angelodlfrtr/attinav/hardware/kicad/components/SCHA63T-K03-05/SCHA63T-K03-05.step

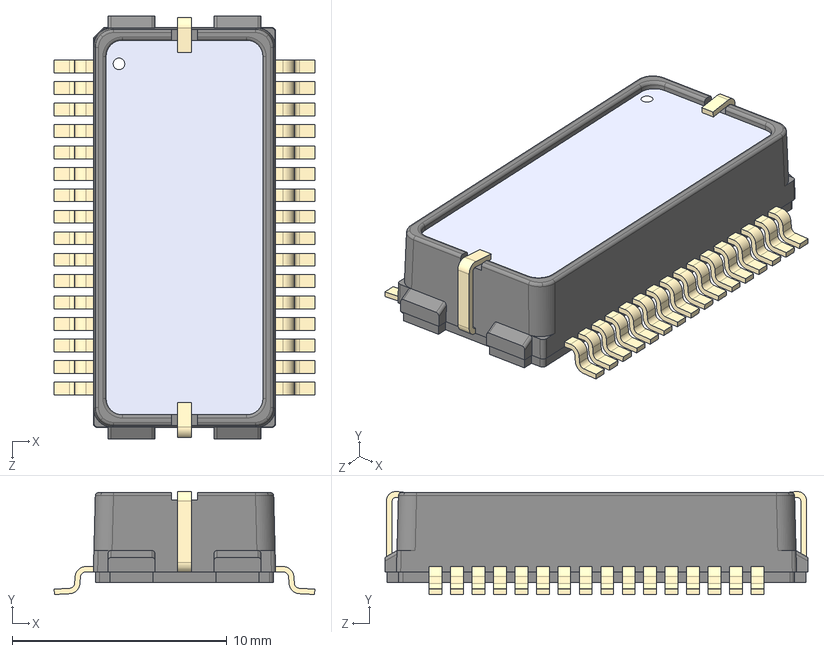
[picture p1: CAD file, 2026-02-02]
hardware/kicad/components/SCHA63T-K03-05/SCHA63T-K03-05.step
12.2 x 4.80 x 19.7 mm
