angelodlfrtr/attinav/hardware/kicad/components/STM32F401CEU6/STM32F401CEU6.stp

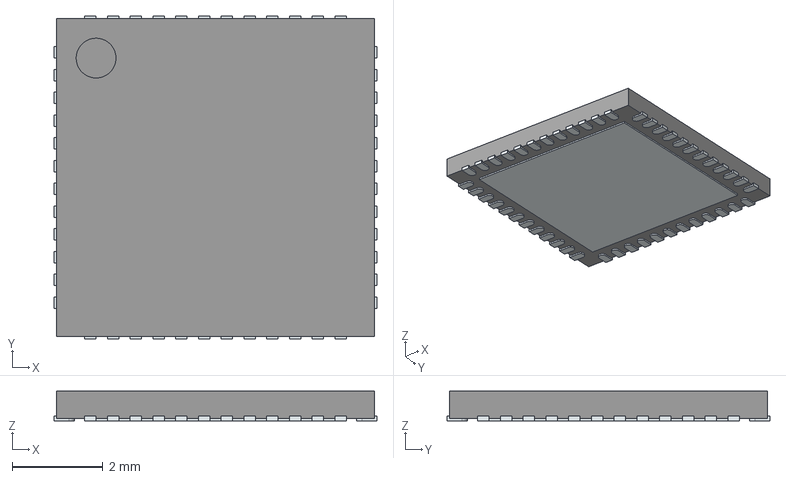
[picture p2: CAD file, 2026-02-02]
hardware/kicad/components/STM32F401CEU6/STM32F401CEU6.stp
7.10 x 7.10 x 0.65 mm
ThermalPin
PinsArrayLR
PinsArrayTB
