angelodlfrtr/attinav/hardware/kicad/components/TS-1088-AR02016/TS-1088-AR02016.step

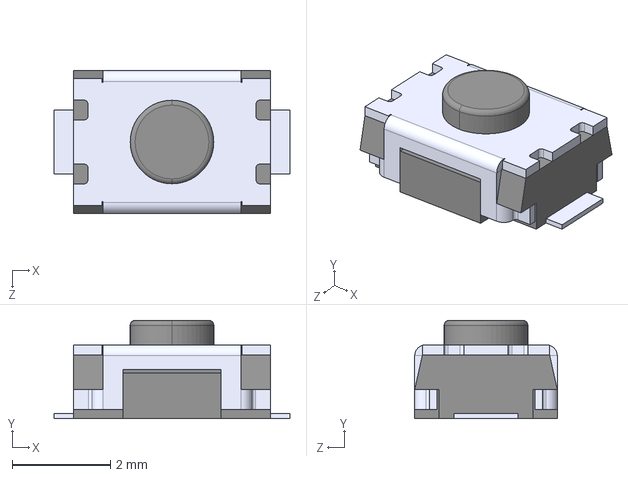
[picture p3: CAD file, 2026-02-02]
hardware/kicad/components/TS-1088-AR02016/TS-1088-AR02016.step
4.80 x 2.00 x 2.90 mm
