angelodlfrtr/attinav/hardware/kicad/components/WIT-RM3100/PNI_3100_CB.step

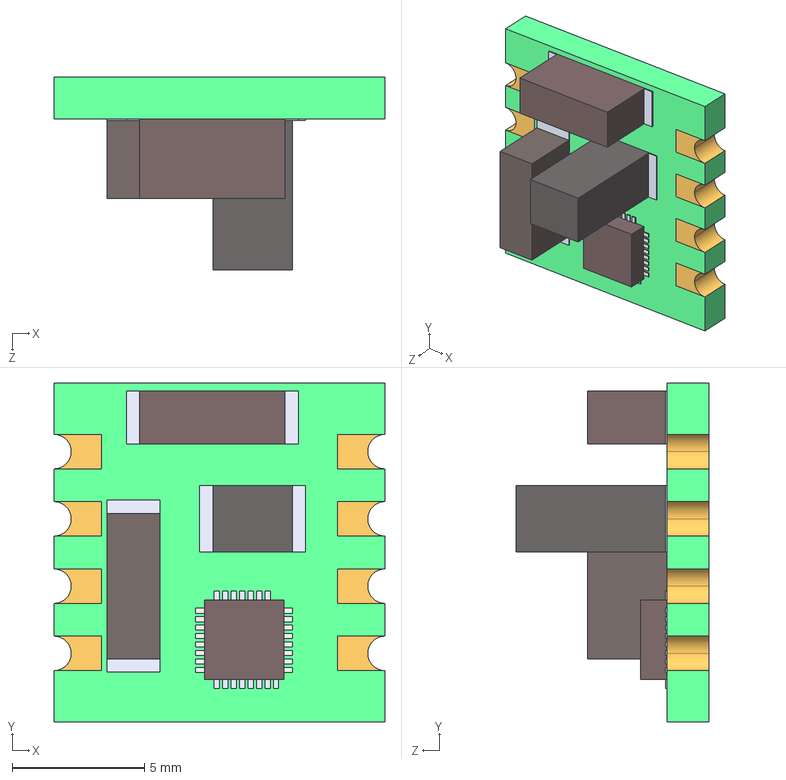
[picture p4: CAD file, 2026-02-02]
hardware/kicad/components/WIT-RM3100/PNI_3100_CB.step
12.5 x 12.8 x 7.30 mm
