angelodlfrtr/attinav/hardware/kicad/attinav.kicad_pcb

## KiCad design hardware/kicad/attinav.kicad_pcb (2026-11-10)

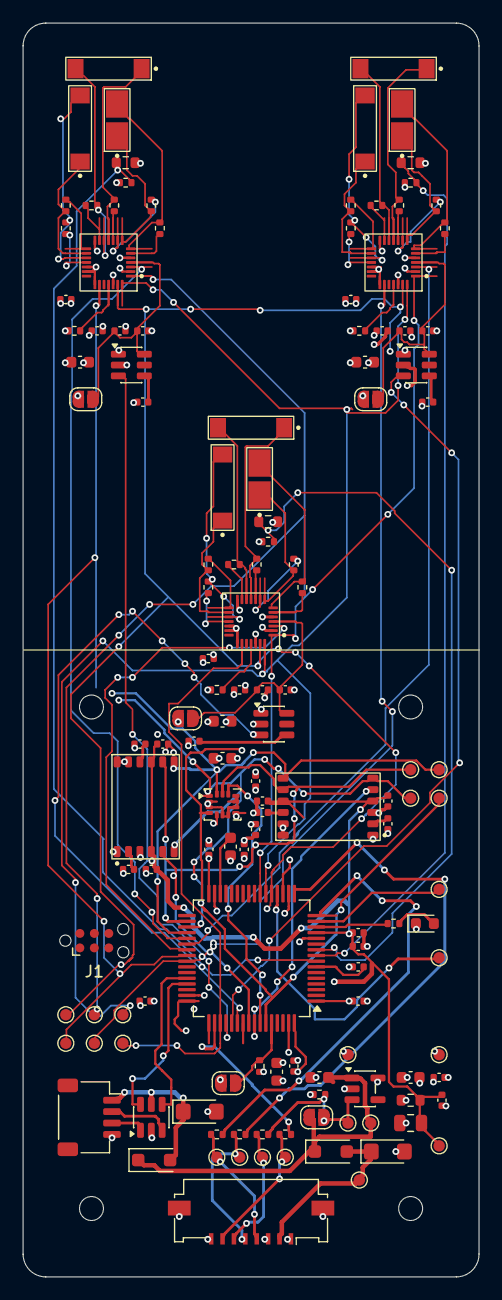
[picture p13: board attinav.kicad_pcb from above]

Board: 6 copper layers, 40.0 x 110.0 mm, 139 parts (0 on the bottom side), 96 nets.

Parts:
C1, C7, C13: 1n/X7R; C_0402_1005Metric
C2, C8, C14, C25, C41: 1u/X7R; C_0402_1005Metric
C3, C4, C5, C9, C10, C11, C15, C16, C17, C27, C34, C35, C36, C37, C39, C40, C43, C45, C46, C47, C48, C49, C50, C51, C52, C55: 100n/X7R; C_0402_1005Metric
C6, C12, C18, C24, C28: 10u/X7R; C_0603_1608Metric
C26: 22u/X7R; C_0805_2012Metric
C38, C42: 4.7u/X7R; C_0603_1608Metric
C53: 10n/X7R; C_0402_1005Metric
C54: 2.2u/X7R; C_0603_1608Metric
D2: LED GREEN; LED_0603_1608Metric
D5, D7: PMEG2010AEH; D_SOD-123F
D6, D8: SMF5V0A; D_SMF
H1, H2: DowelHole; MountingHole_2.1mm
H3, H4: MountingHole; MountingHole_2.1mm
J1: Tag-Connect_TC2030-IDC-NL_2x03_P1.27mm_Vertical
J3: USB pigtail JST SH 4p; JST_SH_SM04B-SRSS-TB_1x04-1MP_P1.00mm_Horizontal
J4: FFC 8p 1.0mm flip-lock; Molex_200528-0080_1x08-1MP_P1.00mm_Horizontal
JP1, JP2, JP3, JP5, JP6: SolderJumper_2_Open; SolderJumper-2_P1.3mm_Open_RoundedPad1.0x1.5mm
L1, L4, L7: Sen-Z-f; PNI_Sen-Z-f
L2, L3, L5, L6, L8, L9: Sen-XY-f; PNI_Sen-XY-f
R1, R9, R17: 10k/0.1%; R_0402_1005Metric
R2, R10, R18: 33k/1%; R_0402_1005Metric
R3, R4, R5, R6, R7, R8, R11, R12, R13, R14, R15, R16, R19, R20, R21, R22, R23, R24: 121R/1%; R_0402_1005Metric
R27: 100k/1%; R_0402_1005Metric
R28: 4.7R/1%; R_0603_1608Metric
R29: 10k/1%; R_0402_1005Metric
R30: 1k/1%; R_0402_1005Metric
R33, R34, R35, R36: 100R/1%; R_0402_1005Metric
TH1, TH2, TH3: PT1000; R_0603_1608Metric
TP1: TP_FFC_TX; TestPoint_Pad_D1.0mm
TP2: TP_FFC_RX; TestPoint_Pad_D1.0mm
TP3: TP_FFC_EN; TestPoint_Pad_D1.0mm
TP4: TP_FFC_QUIET; TestPoint_Pad_D1.0mm
TP6: TP_+5V; TestPoint_Pad_D1.0mm
TP7: TP_+3.3V; TestPoint_Pad_D1.0mm
TP8: TP_+3.3VA; TestPoint_Pad_D1.0mm
TP9: TP_EN; TestPoint_Pad_D1.0mm
TP10: TP_GND; TestPoint_Pad_D1.0mm
TP14: TP_SCLK; TestPoint_Pad_D1.0mm
TP15: TP_MOSI; TestPoint_Pad_D1.0mm
TP16: TP_MISO; TestPoint_Pad_D1.0mm
TP17: TP_DRDY1; TestPoint_Pad_D1.0mm
TP18: TP_DRDY2; TestPoint_Pad_D1.0mm
TP19: TP_DRDY3; TestPoint_Pad_D1.0mm
TP20: TP_PA1; TestPoint_Pad_D1.0mm
TP21: TP_PA4; TestPoint_Pad_D1.0mm
TP23: TP_ACC_SCLK; TestPoint_Pad_D1.0mm
TP24: TP_ACC_MOSI; TestPoint_Pad_D1.0mm
TP25: TP_ACC_MISO; TestPoint_Pad_D1.0mm
TP26: TP_IMU_INT; TestPoint_Pad_D1.0mm
TP27: TP_FFC_5V; TestPoint_Pad_D1.0mm
U1, U3, U5: TPS22917DBV; SOT-23-6
U2, U4, U6: MagI2C 13156; PNI_MagI2C_MLF-28_4x4mm_P0.4mm_NoEP
U7: USBLC6-2SC6; SOT-23-6
U8: TPS7A2033PDBVR; SOT-23-5
U9: STM32U575RGTx; LQFP-64_10x10mm_P0.5mm
U10: ICM-42688-P; LGA-14_3x2.5mm_P0.5mm_LayoutBorder3x4y
U13, U14: SCA3300-D01; Murata_SCA3300-D01

Connections:
+3.3VA: C26.2, C27.2, C40.1, C41.1, C45.2, C46.1, C49.2, C50.1, R28.2, TP8.1 (1_1), U9.13 (VDDA), U13.4 (VDD), U13.9 (DVIO), U14.4 (VDD), U14.9 (DVIO)
+3V3: C4.1, C5.1, C6.1, C10.1, C11.1, C12.1, C16.1, C17.1, C18.1, C24.2, C25.2, C34.1, C35.1, C36.1, C37.1, C38.1, C39.1, C53.1, C54.2, C55.2, JP1.1 (A), JP2.1 (A), JP3.1 (A), JP6.1 (A), R1.1, R9.1, R17.1, R28.1, TP7.1 (1_1), U1.1 (VIN), U2.14 (DVDD), U2.26 (DVDD), U3.1 (VIN), U4.14 (DVDD), U4.26 (DVDD), U5.1 (VIN), U6.14 (DVDD), U6.26 (DVDD), U8.5 (OUT), U9.1 (VBAT), U9.19 (VDD), U9.32 (VDD), U9.48 (VDDUSB), U9.64 (VDD), U10.5 (VDDIO), U10.8 (VDD)
+5V: C28.2, D5.1 (K), D7.1 (K), JP5.1 (A), TP6.1 (1_1), U8.1 (IN)
/5V_FFC: D5.2 (A), D6.1 (A1), J4.2, TP27.1 (1_1)
/ACC_MISO: TP25.1 (1_1), U9.35 (PB14), U10.1 (AP_SDO/AP_AD0), U13.6 (MISO), U14.6 (MISO)
/ACC_MOSI: TP24.1 (1_1), U9.36 (PB15), U10.14 (AP_SDA/AP_SDIO/AP_SDI), U13.7 (MOSI), U14.7 (MOSI)
/ACC_SCLK: TP23.1 (1_1), U9.34 (PB13), U10.13 (AP_SCL/AP_SCLK), U13.8 (SCK), U14.8 (SCK)
/AVDD_EN1: U1.3 (ON), U9.52 (PC11)
/AVDD_EN2: U3.3 (ON), U9.53 (PC12)
/AVDD_EN3: U5.3 (ON), U9.54 (PD2)
/CS_ACC1: U9.56 (PB4), U13.5 (CSB)
/CS_ACC2: U9.57 (PB5), U14.5 (CSB)
/CS_IMU: U9.58 (PB6), U10.12 (AP_CS)
/CS_MAG1: U2.3 (SSN/SA0), U9.37 (PC6)
/CS_MAG2: U4.3 (SSN/SA0), U9.38 (PC7)
/CS_MAG3: U6.3 (SSN/SA0), U9.39 (PC8)
/DRDY_MAG1: TP17.1 (1_1), U2.23 (DRDY), U9.40 (PC9)
/DRDY_MAG2: TP18.1 (1_1), U4.23 (DRDY), U9.41 (PA8)
/DRDY_MAG3: TP19.1 (1_1), U6.23 (DRDY), U9.51 (PC10)
/EN: JP5.2 (B), R27.2, R33.2, TP9.1 (1_1), U8.3 (EN)
/IMU_INT: TP26.1 (1_1), U9.59 (PB7), U10.4 (INT1/INT)
/INTERFACE/FFC_EN: J4.6, R33.1, TP3.1 (1_1)
/INTERFACE/FFC_QUIET: J4.7, R34.1, TP4.1 (1_1)
/INTERFACE/FFC_RX: J4.5, R35.1, TP2.1 (1_1)
/INTERFACE/FFC_TX: J4.4, R36.1, TP1.1 (1_1)
/MAG1/AVDD_SW: C2.1, C3.1, JP1.2 (B), U1.6 (VOUT), U2.4 (AVDD)
/MAG2/AVDD_SW: C8.1, C9.1, JP2.2 (B), U3.6 (VOUT), U4.4 (AVDD)
/MAG3/AVDD_SW: C14.1, C15.1, JP3.2 (B), U5.6 (VOUT), U6.4 (AVDD)
/MCU/BOOT0: JP6.2 (B), R29.2, U9.60 (PH3)
/MCU/NRST: C43.2, U9.7 (NRST)
/MCU/TP_PA1: TP20.1 (1_1), U9.15 (PA1)
/MCU/TP_PA4: TP21.1 (1_1), U9.20 (PA4)
/MCU/USB_DM: U7.4 (I/O2), U9.44 (PA11)
/MCU/USB_DP: U7.6 (I/O1), U9.45 (PA12)
/QUIET: R34.2, U9.50 (PA15)
/SPI_MISO: TP16.1 (1_1), U2.28 (MISO/SA1), U4.28 (MISO/SA1), U6.28 (MISO/SA1), U9.22 (PA6)
/SPI_MOSI: TP15.1 (1_1), U2.1 (MOSI/SDA), U4.1 (MOSI/SDA), U6.1 (MOSI/SDA), U9.23 (PA7)
/SPI_SCLK: TP14.1 (1_1), U2.27 (SCLK/SCL), U4.27 (SCLK/SCL), U6.27 (SCLK/SCL), U9.21 (PA5)
/TEMP_MAG1: R1.2, TH1.1, U9.8 (PC0)
/TEMP_MAG2: R9.2, TH2.1, U9.9 (PC1)
/TEMP_MAG3: R17.2, TH3.1, U9.10 (PC2)
/UART_RX: R35.2, U9.17 (PA3)
/UART_TX: R36.2, U9.16 (PA2)
/VBUS: D7.2 (A), D8.1 (A1), J3.1, U7.5 (VBUS)
GND: C1.1, C2.2, C3.2, C4.2, C5.2, C6.2, C7.1, C8.2, C9.2, C10.2, C11.2, C12.2, C13.1, C14.2, C15.2, C16.2, C17.2, C18.2, C24.1, C25.1, C26.1, C27.1, C28.1, C34.2, C35.2, C36.2, C37.2, C38.2, C39.2, C40.2, C41.2, C42.1, C43.1, C45.1, C46.2, C47.1, C48.1, C49.1, C50.2, C51.1, C52.1, C53.2, C54.1, C55.1, D2.1 (K), D6.2 (A2), D8.2 (A2), J3.4, J4.1, J4.3, J4.8, J4.MP (MountPin), R2.1, R10.1, R18.1, R27.1, R29.1, TH1.2, TH2.2, TH3.2, TP10.1 (1_1), U1.2 (GND), U2.2 (RES), U2.5 (AVSS), U2.19 (DVSS), U2.20 (RES), U2.22 (I2CEN), U3.2 (GND), U4.2 (RES), U4.5 (AVSS), U4.19 (DVSS), U4.20 (RES), U4.22 (I2CEN), U5.2 (GND), U6.2 (RES), U6.5 (AVSS), U6.19 (DVSS), U6.20 (RES), U6.22 (I2CEN), U7.2 (GND), U8.2 (GND), U9.12 (VSSA), U9.18 (VSS), U9.31 (VSS), U9.47 (VSS), U9.63 (VSS), U10.2 (RESV), U10.3 (RESV), U10.6 (GND), U10.7 (RESV), U10.9 (INT2/FSYNC/CLKIN), U10.10 (RESV), U10.11 (RESV), U13.1 (AVSS), U13.3 (RESERVED), U13.11 (DVSS), U13.12 (EMC_GND), U14.1 (AVSS), U14.3 (RESERVED), U14.11 (DVSS), U14.12 (EMC_GND)
unnamed: D2.2 (A), R30.2
unnamed: J3.2, U7.3 (I/O2)
unnamed: J3.3, U7.1 (I/O1)
unnamed: L1.1 (1_POL), R4.1, U2.8 (ZINN)
unnamed: L4.1 (1_POL), R12.1, U4.8 (ZINN)
unnamed: L7.1 (1_POL), R20.1, U6.8 (ZINN)
unnamed: C1.2, U1.4 (CT)
unnamed: R2.2, U2.25 (REXT)
unnamed: R5.2, U2.18 (XDRVN)
unnamed: R8.2, U2.15 (XDRVP)
unnamed: L3.2, R5.1, U2.17 (XINN)
unnamed: L3.1, R8.1, U2.16 (XINP)
unnamed: R3.2, U2.13 (YDRVN)
unnamed: R6.2, U2.10 (YDRVP)
unnamed: L2.2, R3.1, U2.12 (YINN)
unnamed: L2.1, R6.1, U2.11 (YINP)
unnamed: R4.2, U2.9 (ZDRVN)
unnamed: R7.2, U2.6 (ZDRVP)
unnamed: L1.2, R7.1, U2.7 (ZINP)
unnamed: C7.2, U3.4 (CT)
unnamed: R10.2, U4.25 (REXT)
unnamed: R13.2, U4.18 (XDRVN)
unnamed: R16.2, U4.15 (XDRVP)
unnamed: L6.2, R13.1, U4.17 (XINN)
unnamed: L6.1, R16.1, U4.16 (XINP)
unnamed: R11.2, U4.13 (YDRVN)
unnamed: R14.2, U4.10 (YDRVP)
unnamed: L5.2, R11.1, U4.12 (YINN)
unnamed: L5.1, R14.1, U4.11 (YINP)
unnamed: R12.2, U4.9 (ZDRVN)
unnamed: R15.2, U4.6 (ZDRVP)
unnamed: L4.2, R15.1, U4.7 (ZINP)
unnamed: C13.2, U5.4 (CT)
unnamed: R18.2, U6.25 (REXT)
unnamed: R21.2, U6.18 (XDRVN)
unnamed: R24.2, U6.15 (XDRVP)
unnamed: L9.2, R21.1, U6.17 (XINN)
unnamed: L9.1, R24.1, U6.16 (XINP)
unnamed: R19.2, U6.13 (YDRVN)
unnamed: R22.2, U6.10 (YDRVP)
unnamed: L8.2, R19.1, U6.12 (YINN)
unnamed: L8.1, R22.1, U6.11 (YINP)
unnamed: R20.2, U6.9 (ZDRVN)
unnamed: R23.2, U6.6 (ZDRVP)
unnamed: L7.2, R23.1, U6.7 (ZINP)
unnamed: R30.1, U9.14 (PA0)
unnamed: C42.2, U9.30 (VCAP)
unnamed: C48.2, U13.2 (A_EXTC)
unnamed: C47.2, U13.10 (D_EXTC)
unnamed: C52.2, U14.2 (A_EXTC)
unnamed: C51.2, U14.10 (D_EXTC)
