angelodlfrtr/attinav/(commit log)

2026-09-20 Before rework
    [attinav.kicad_pcb, attinav.kicad_sch]
2026-11-01 docs(hardware): add Rev A review and Rev B design notes
    Rev A review found three functional defects, verified against a
    kicad-cli netlist and direct PCB geometry parsing rather than the
    Konnect audit tools, which report false positives on this project:
    - D1/D2 Schottky pair has a floating common node and protects nothing
    - NT1 net-tie hard-shorts BOOT0 to GND, defeating the J1 boot jumper
    - C15/C16 are 20pF against Y1's CL=20pF; need 33pF (~+60ppm fast)
    README.md records the full review plus the Rev B architecture and the
    reasoning behind it: the tan(magnetic dip) ~2x amplification of tilt
    error into azimuth error, the error budget reaching 0.1 deg azimuth /
    0.05 deg inclination, sensor se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
2026-11-01 docs(hardware): size rationale, datum correction, housing interface spec
    Scope the housing material explicitly as an interface spec the module
    depends on, not a design — this repo covers the AHRS module only.
    Board grows 80x36 -> 110x40 mm. Record why that is comfortable rather
    than minimal: four of the five error-budget terms are size-independent,
    so the accuracy-limited minimum is ~70x35 mm and nothing in the budget
    improves above ~75x35. Board length is bought for anomaly-detection
    sensitivity instead — a 35 nT anomaly is the whole 0.1 deg azimuth
    budget, and detecting it has only 2x margin at a 20 mm baseline versus
    5x at 50 mm. Note the transverse baseline is capped at ~25 mm by th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
2026-11-01 docs(hardware): fix H1 verification path, Rev A was never fabricated
    The H1 eddy-current task said to test against the Rev A board, but Rev A
    was only designed, never built, so there is no hardware to measure.
    Replace with three viable paths: check the PNI sensor suite manual
    (free, may settle it); design around it with the hybrid non-conductive
    nose (cheap, needs no answer); or buy one assembled RM3100 breakout
    (~EUR 35) alongside the Phase 2 parts order to get the actual number,
    which also gives an early target for calibration firmware.
    Note explicitly that deferring H1 to Rev B bring-up while committing to
    a one-piece aluminium chassis is the one combination to avoid, since a
    single bil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
2026-11-01 docs(hardware): scope the smartphone to bench tool and reference source
    Split the previously blanket "iPhone / 3D scan: out of scope" decision.
    3D scan integration stays parked as a carrier-level feature needing no
    module changes. The phone itself earns a narrow, zero-development role:
    - Magnetic screening during part selection, which is immediately useful
    given no hardware exists yet. Records the honest limit: ~0.1-0.5 uT
    resolution against a 35 nT budget answers "is this steel?" and nothing
    finer, so it covers dowels, cells and tripod inserts but not a single
    0603's Ni barrier termination.
    - Position -> IGRF/WMM for expected |B|, dip and declination, plus time
    and position for s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
2026-11-01 docs(hardware): resolve H1 and fix coil decoupling guidance from PNI manual
    Checked the RM3100 & RM2100 Sensor Suite User Manual, Doc 1017252 R07.
    H1 (eddy-current loading of the coils by a nearby aluminium housing)
    is downgraded from blocking to low risk. Section 4.2.2 lists only three
    hazards -- large electric currents, large masses of FERROUS material,
    and permanent magnets -- and a keyword search of the manual for eddy /
    aluminium / conductive / metal / enclosure / housing returns nothing.
    Weak but real evidence against the concern, since the RM3100 ships in
    drone, marine and space products that sit inside aluminium structures.
    The hybrid non-conductive nose stays preferred as cheap ins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
2026-11-01 docs(hardware): fix six issues found in a full logic recheck
    A. Housing argument was internally inconsistent. The theta ~= 2*delta/L
    analysis that "caps a printed housing at 0.25 deg" only applies to a
    removable board relocated by dowels, but H12 already requires the
    board to be bonded and the sensor->sight-axis transform calibrated.
    Under those conditions dowel clearance is irrelevant and only later
    movement matters. Rewrite the section as "The housing requirement,
    corrected": the hard requirement is dimensional stability (CTE,
    creep, moisture), not locating precision. Machined aluminium stays
    the recommendation on stability and thermal-mass grounds; soften H2
    fro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
2026-11-01 chore(hardware): untrack .history/ nested-repo gitlink
    hardware/kicad/.history is an editor local-history folder that
    initialises its own .git. "Before rework" (268ad54) swept it into the
    index as a bare gitlink (mode 160000, no .gitmodules), so it showed as a
    phantom modified submodule on every status and the .gitignore rule added
    in e24f976 could not take effect -- ignore rules never apply to tracked
    paths.
    Removed from the index only (--cached); the directory and its contents
    are untouched on disk. With the entry gone, .gitignore:51 now matches it.
    Assisted-by: Claude Code (Claude Fable 5.1, claude-fable-5-1)
2026-11-01 docs(hardware): correct board geometry claims from a placement calculation
    Re-derived the 110x40 mm floorplan from real footprint dimensions rather
    than re-reading earlier prose. The board size stands; three statements
    about it did not.
    Triad envelope. Each magnetometer triad is an 8x20 mm block -- coils
    (8x8) + the >=5 mm gap PNI requires between coils and capacitors + the
    MagI2C with its decoupling (7x7) -- not the ~15 mm square assumed
    earlier. Recomputed baselines: A-B 28 mm (was stated as 24), A-C/B-C
    35.8 mm (was stated as ~40). Gradient floor 59 nT/m, 3.6x margin on the
    210 nT/m threat. Dowel span L=44 mm, theta 0.016 deg.
    Missing load-bearing rule. Every triad must be oriented with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
2026-11-01 docs(hardware): final parts-list review -- six changes, core sensors confirmed
    Challenged every part against real alternatives. RM3100 x3, SCA3300-D01
    x2, ICM-42688-P and the TPS7A20-class LDO all hold: SCL3300's high-res
    modes are +/-10 deg (useless at +/-90), IIS2ICLX is 2-axis, ADXL355 has
    thermal-gradient sensitivity, servo accelerometers are the only genuine
    step up and are single-axis at ~10x cost. The parts are not the accuracy
    limiter.
    Six changes to the supporting BOM:
    1. Drop both per-accelerometer TMP117s. The SCA3300 exposes a die
    temperature sensor (Table 3: 18.9 LSB/degC, 0.053 degC resolution,
    +/-10 degC absolute offset) read in the same SPI frame. Compensation
    uses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
2026-11-01 docs(hardware): JLCPCB as the fab -- constraints become design inputs
    The board will be hand-drawn and fabricated and assembled at JLCPCB.
    Their published 6-layer capabilities, verified Nov 2026, force or
    resolve several open decisions:
    Surface finish: JLCPCB offers only OSP or ENIG at 6 layers -- no HASL
    (planarity), no immersion silver. The "never ENIG" rule therefore
    collapses to OSP, which is also the best outcome: non-metallic, the
    flattest finish for the 0.4 mm MLF, no surcharge. Caveat recorded: ~6
    month shelf life and bare copper on rework, so order fab and assembly
    together.
    Stackup: JLC06161H-3313 confirmed as Rev A's intent. In2/In3 sit across
    the 0.109 mm 2116 prepreg, so the t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
2026-11-01 docs(hardware): KiCad Board Setup values ready for transcription
    The intent was to enter the JLCPCB stackup and design rules into the
    KiCad project via Konnect. That is blocked this session: the Konnect MCP
    server is disconnected, and both targets (.kicad_pro constraints,
    .kicad_pcb stackup and copper_finish) are protected files that must not
    be edited directly. Instead, record the exact Board Setup field values
    so the entry is a transcription job, via a fresh Konnect session or the
    GUI.
    Constraints: min clearance 0.15, min track 0.15, min via 0.45/0.3,
    annular 0.075, through-hole 0.3, copper-to-hole 0.25, copper-to-edge
    0.25, hole-to-hole 0.25 with a note that JLCPCB's PTH-to-PTH limit of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
2026-11-01 docs(hardware): interconnect -- UART over 8-pin latching FFC, with reasoning
    The roadmap already named "UART over 8-pin FFC" but gave only the
    loop-area argument. Record the decisive one: housing path 2 bonds the
    AHRS board to the chassis and captures its position by calibration, so
    the carrier link must be mechanically compliant. Any rigid bridge --
    castellated edges, stacking headers, mezzanine connectors -- transmits
    carrier flex, screen presses and assembly tolerance into the calibrated
    frame. Castellations additionally make the carrier the structural
    reference and put its copper under the coil zone.
    Specify 1.0 mm pitch flip-latch FFC connectors on both boards, and spend
    the two spare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
2026-11-01 hardware: clear Rev A design to start Rev B in place
    Rev A schematic and board removed from the working project to begin the
    Rev B redraw in the same KiCad project, so the 6-layer stackup and board
    setup carry over. Rev A remains complete at 268ad54 ("Before rework");
    the Rev A defect review in hardware/kicad/README.md refers to that
    revision.
    What survived the clear-out: the .kicad_pcb setup and stackup block
    (still copper_finish "None" and Rev A thicknesses -- to be updated per
    ROADMAP "KiCad Board Setup -- values to enter") and the Default/Power
    netclass definitions. Netclass assignments are null and must be re-made
    as Rev B nets appear.
    Assisted-by: Claude Code (Claude Fable 5.1, claud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
    [attinav.kicad_pcb, attinav.kicad_sch]
2026-11-01 hardware: board setup -- JLC06161H-3313 stackup, OSP, JLCPCB constraints
    Entered in KiCad Board Setup and verified on disk against the targets in
    ROADMAP "KiCad Board Setup -- values to enter".
    Constraints (.kicad_pro): min clearance 0.0 -> 0.15, min track width
    0.0 -> 0.15, min via diameter 0.4 -> 0.45. Through-hole 0.3,
    hole-to-hole 0.25, annular 0.075, copper-to-edge 0.25 and
    copper-to-hole 0.25 unchanged.
    Stackup (.kicad_pcb): JLC06161H-3313 -- 1 oz outer copper, 0.5 oz
    (0.0152 mm) inner copper, 3313 prepreg 0.0994 mm er 4.1 at L1-L2 and
    L5-L6, 0.55 mm cores, 2116 prepreg 0.1088 mm between In2 and In3.
    Dielectric types set to prepreg/core. copper_finish None -> OSP, the
    only non-nickel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
    [attinav.kicad_pcb]
2026-11-01 docs(hardware): tick Phase 6 board-setup items
    Design rules and copper_finish are now set in the project (previous
    commit); mark both Phase 6 checkboxes done so the roadmap reflects it.
    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
2026-11-01 hardware: add attinav library -- RM3100 coils, MagI2C, SCA3300, ICM symbol
    New project library components/attinav (attinav.pretty + attinav.kicad_sym),
    registered as "attinav" in the project fp-lib-table and sym-lib-table.
    Authored through Konnect from primary sources; nothing existed in the
    installed KiCad libraries, in the Rev A project libraries, or online for
    the PNI parts.
    Footprints (4):
    - PNI_Sen-XY-f: lands 1.40x1.70 at 5.80 c-c; paste 0.60x1.20 centred on
    the 5.30 c-c termination lines, i.e. 0.25 inward of the land centre,
    on separate F.Paste-only pads. PNI UM 1017252 R07 Fig 3-3. The 5.30
    callout is the termination pitch, not the land pitch -- the nested
    4.70/4.40/4.15 cal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
2026-11-01 docs(hardware): Phase 3 library done -- tick items, record lib IDs and findings
    Tick the six completed Phase 3 items and add the results table: which
    lib ID to use for each part, which came from stock, the Sen-XY-f land
    pitch finding (5.80 lands / 5.30 paste), the Sen-Z-f polarity rule, the
    MagI2C no-EP derivation, the courtyard defect found and fixed, and the
    two known cosmetic limitations. Note that Konnect's library search sees
    only project libraries, which matters for later Konnect-driven
    placement. Only the physical-part footprint check remains in Phase 3.
    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
2026-11-01 hardware: magnetometer triad sheet, instanced 3x on the root
    Add mag.kicad_sch (RM3100 triad: MagI2C, 2x Sen-XY-f + Sen-Z-f, 121R in
    series with each DRV pin, REXT 33k, DVDD decoupling, AVDD via TPS22917DBV
    load switch with solder-jumper bypass, PT1000 + 10k 0.1% divider on TEMP)
    and instantiate it as MAG1..3 on the A4 root with shared SPI and per-
    instance CS/DRDY/AVDD_EN/TEMP labels. kicad-cli netlist verified: all 18
    coil nodes = coil pin + IN pin + resistor pin; remaining ERC items wait
    for the MCU and power sheets.
    Docs: tick Phase 4 items for the mag sheet with its open follow-ups;
    README tooling caveats now record the stale Konnect library-path cause
    and the Konnect schematic-buildin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
    [attinav.kicad_sch, mag.kicad_sch]
2026-11-01 hardware: redraw mag sheet for readability, restore footprints
    Manual redraw of mag.kicad_sch in eeschema (layout, descriptive values
    such as 121R/1% and 100n/X7R, note text), root sheet instances
    compacted. The redraw dropped the Footprint field on every part except
    the TPS22917; restored them (attinav PNI footprints on MagI2C and coils,
    0402 R/C, 0603 for the 10u and PT1000, 1.3 mm solder jumper). BOM shows
    no empty footprint; kicad-cli netlist unchanged: 18/18 coil nodes =
    coil pin + IN pin + resistor pin.
    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
    [attinav.kicad_sch, mag.kicad_sch]
2026-11-01 hardware: power sheet -- Schottky OR-ed 5 V, TPS7A2033 LDO, RC analog rail
    Add power.kicad_sch and instance it as POWER on the root. 5V_FFC and USB
    VBUS are OR-ed through two PMEG2010AEH into +5V with an SMF5V0A TVS on
    each input; TPS7A2033PDBVR (300 mA, 7 uVrms, LCSC C2862740, genuine TI
    only) regulates to +3V3 with 10u in, 10u + 1u out. EN: high = on, 100k
    pull-down, solder jumper to +5V for standalone bench power. +3.3VA via
    4.7R + 22u + 100n RC split (no ferrite: no magnetic material). PWR_FLAG
    on +5V, +3.3VA, GND; test pads on every rail and EN. Root labels 5V_FFC,
    VBUS, EN wait for the interface and MCU sheets.
    Sheet redrawn by hand for readability; footprints re-assigned after the
    re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
    [attinav.kicad_sch, power.kicad_sch]
2026-11-01 docs(hardware): MCU is STM32U575RGT6 (LCSC C5270980), U585RIT6 as drop-in
    Replace "consign U585RIT6 or LQFP-100 VIT6Q" with the STM32U575RGT6:
    same LQFP-64 non-Q (LDO-only, VCAP) pinout, 1 MB flash, no crypto
    accelerators, in stock at LCSC. The U585RIT6 stays a zero-change
    upgrade; stock KiCad symbols STM32U575RGTx and STM32U585RITx have
    identical pin blocks.
    Record from DS13737 Fig. 11/12 why Q and non-Q LQFP-64 parts are not
    interchangeable (pins 24-33 and 62) and the dual-fit jumper scheme as a
    future option only.
    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
2026-11-01 hardware: MCU sheet -- STM32U575RGT6, SPI1/SPI2/LPUART1 pin plan, USB pigtail, SWD pads
    Add mcu.kicad_sch and instance it as MCU on the root. STM32U575RGT6
    (non-Q, VCAP 4.7u), 100n per VDD + 4.7u bulk, VDDA from +3.3VA, NRST
    cap, BOOT0 pull-down with solder jumper for USB DFU, status LED on PA0.
    SPI1 to the three RM3100 (CS PC6-8, DRDY PC9/PA8/PC10 on distinct
    EXTI lines, AVDD_EN PC11/PC12/PD2, Pt1000 dividers on PC0-2), SPI2
    reserved for 2x SCA3300 + ICM-42688-P (PB13-15, CS PB4-6, INT PB7),
    LPUART1 on PA2/PA3 to the carrier, QUIET on PA15. USB FS device on
    PA11/PA12 through USBLC6-2SC6 to a JST SH 4-pin pigtail header (no
    steel-shell receptacle on a magnetometer board). SWD on Tag-Connect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
    [attinav.kicad_sch, mcu.kicad_sch]
2026-11-02 hardware: accel and interface sheets -- schematic complete
    Sheets redrawn by hand for readability; footprints re-assigned after
    the redraw.
    accel.kicad_sch (ACCEL): 2x SCA3300-D01 on SPI2 (CS_ACC1/CS_ACC2), each
    with the four 100n of Murata DS Fig. 15 (VDD, A_EXTC, D_EXTC, DVIO);
    VDD and DVIO both on +3.3VA because Murata forbids DVIO above VDD and
    +3V3 sits ~60 mV above +3.3VA. ICM-42688-P on SPI2 (CS_IMU, INT1 to
    IMU_INT) on +3V3 with 100n + 2.2u / 10n per TDK Table 11, RESV and
    FSYNC to GND. Sheet note: ACC2 rotated 90 deg about Z from ACC1.
    interface.kicad_sch (INTERFACE): 8-pin 1.0 mm FFC, Molex 200528-0080
    flip-lock, pinout GND 5V GND TX RX EN QUIET GND, hold-downs to GND,
    100R serie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
    [accel.kicad_sch, attinav.kicad_sch, interface.kicad_sch]
2026-11-02 hardware: SCA3300 MISO tri-state; docs: durable KiCad library fix
    Library: attinav:SCA3300-D01 pin 6 (MISO) is now Tri-state, updated
    into accel.kicad_sch; the two accelerometers on SPI2 no longer raise an
    ERC Output-to-Output error. kicad-cli ERC is down to one benign warning
    (ICM FSYNC tied to GND vs the GND PWR_FLAG). BOM has no empty
    footprint. Default footprints in the attinav symbols are still empty.
    Docs: Konnect now starts through a launcher that reads KICAD10_*_DIR
    from the system kicad-cli wrapper at every start, instead of hardcoded
    Nix store paths that went stale on rebuilds. The user's global
    sym/fp-lib-table were replaced with the flat stock tables (all entries
    via path variab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
    [accel.kicad_sch, attinav.kicad_sch]
2026-11-08 feat: remove refs from pcb
    [attinav.kicad_pcb, attinav.kicad_sch, mcu.kicad_sch, power.kicad_sch]
2026-11-10 hardware: route Rev B PCB, MCU sheet touch-ups, fine-pitch DRC rule
    All nets routed on 2026-11-09. Konnect cannot delete 36 stale vias; they
    are listed in hardware/kicad/stale_vias_to_delete.txt for a manual
    Cleanup Tracks & Vias pass, after which J1 (Tag-Connect) still needs its
    nets updated from the schematic and routed.
    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
    [attinav.kicad_pcb, mcu.kicad_sch]
2026-11-10 firmware: Rust/Embassy firmware for Rev B with OTA bootloader
    Workspace of four crates for the STM32U575RGT6:
    - attinav-core (no_std, host-tested): vector maths, survey geometry,
    Heeb/DistoX affine calibration model with up to four temperature sets,
    steppable Levenberg-Marquardt solver for the 14x4 shot procedure,
    quality flags (triad agreement, norms, dip, motion, noise), COBS +
    CRC-16 host protocol codec, power-fail-safe flash record framing.
    - attinav-sensors: async embedded-hal drivers for RM3100, SCA3300
    (frame CRC and echoed-opcode checks) and ICM-42688-P, mock-tested.
    - attinav-fw: engine (shots, streaming, calibration sessions,
    configuration, OTA staging), USB CDC-ACM an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
    [board.rs, calibration.rs, crc.rs, ecc.rs, engine.rs, icm42688.rs, lib.rs]
2026-11-10 client: Tauri desktop client with protocol-level simulator
    Tauri v2 + React 19 + Redux Toolkit + Tailwind v4 application to test,
    calibrate, visualise, configure and update the module over USB or a
    UART adapter. The Rust side links attinav-core so codec, calibration
    model and solver are the firmware's own code.
    Pages: dashboard, shots (compass/inclinometer, raw statistics, CSV),
    raw streaming on canvas strip charts, 14x4 calibration procedure with
    solve/store/import/export, configuration with the firmware's validation
    rules, firmware update with progress, frame console, simulator knobs.
    A simulated device behind the real COBS protocol (distinct affine truth
    models per sensor, noise, pose,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
    [lib.rs, link.rs, main.rs]
2026-11-10 docs: rewrite root README for Rev B and the software projects
    Status table, current part list (replaces the Rev A one), pointers to
    the firmware, client and Makefile entry points.
    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
2026-11-10 solver: calibrate the laser axis, reject mirrored and outlier solutions
    Deep review of the calibration maths, judged with a new Monte-Carlo
    harness (attinav-core/examples/montecarlo.rs) that calibrates random
    realistic instruments and scores azimuth/inclination on fresh poses.
    - Accelerometer 1 was forced upper-triangular, equating its X axis with
    the laser axis; any package tilt or cross-axis term became an
    uncorrectable error (0.16 deg residual even noiseless, most fits with
    a 1.5 deg tilt rejected). It now has a full matrix with one roll-gauge
    element; the roll invariance within each group defines the laser axis.
    - The pair problem is mirror-symmetric and the start search include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
    [calibration.rs, protocol.rs, solver.rs, survey.rs, wire.rs]
2026-11-10 firmware: mirror engine warnings and state changes to the host as Log frames
    New hostlog module: host_warn!/host_info!/host_error! emit the defmt
    record and broadcast the same line as a Log frame (non-blocking, 96 byte
    text). Engine, sensor and store warnings, flash save failures and the
    state changes worth seeing (record loaded/saved, update begin/verified/
    aborted, trial image confirmed, solve timing) go through it; the link
    layer never logs through the links it drives.
    Client toasts device warnings and errors; the simulator emits the same
    lines at boot so the path can be exercised without hardware. PROTOCOL.md
    and the firmware README describe what is forwarded.
    Assisted-by: Claude Code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
    [engine.rs, hostlog.rs, main.rs, sensors.rs, store.rs]
